calebschmurr/AUNA_Test_Box/Computer_App/Tests/CCC Test/img4.png

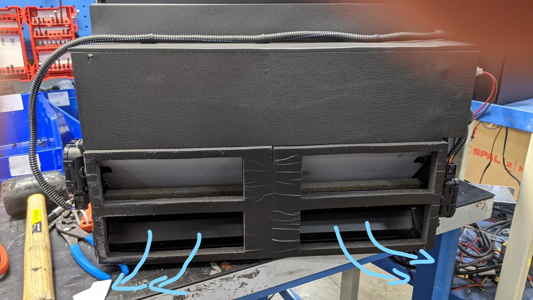
Computer_App/Tests/CCC Test/img4.png
