calebschmurr/AUNA_Test_Box/Computer_App/Tests/H49 Test/img1.png

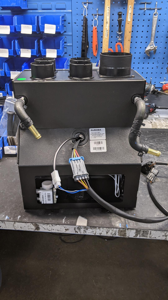
Computer_App/Tests/H49 Test/img1.png
