calebschmurr/AUNA_Test_Box/README.md

# AUNA_Test_Box
AUNA Test Box Program.

For use by Aurora North America

Caleb Schmurr
1/18/2021
