calebschmurr/AUNA_Test_Box/Computer_App/demo_img.png

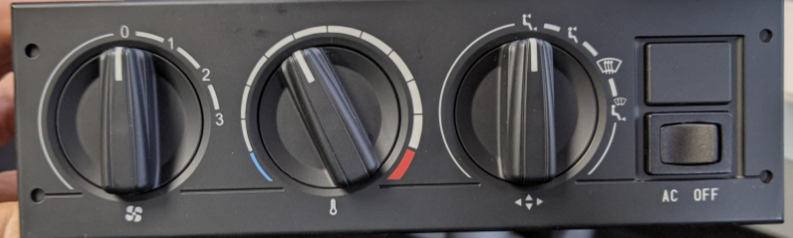
Computer_App/demo_img.png
