calebschmurr/AUNA_Test_Box/Box_Layout/Parts_List.xlsx

No | Part | Description | Quantity/Box | Link | Cost | Quantity | Total Number | Total Cost | Total:
X1 | 1-967624-1 | 18 Pole Connector Housing | 1 | https://www.digikey.com/en/products/detail/te-connectivity-amp-connectors/1-967624-1/2054114 | $1.85 | 1 | 1 | $1.85 | 162.3
X1 | 927768-3 | X1 Connector Pins | 100 | https://www.mouser.com/ProductDetail/TE-Connectivity-AMP/927768-3-CUT-STRIP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 | $0.15 |  | 100 | $15.00
X1 | 967634-1 | X1 Connector Pins | 1 | https://www.mouser.com/ProductDetail/TE-Connectivity/967634-1?qs=rjnFDYRVT0rJvfzEmt5HXw%3D%3D | $0.60 |  | 1 | $0.60
 |  |  |  |  |  |  | 0 | $0.00
X1 Mate | 1-967629-1 |  | 3 | https://www.mouser.com/ProductDetail/TE-Connectivity-AMP/6-968974-1?qs=VCyXNGXRS8bfC8%252Bz99ZYjg%3D%3D | $1.87 |  | 3 | $5.61
X1 Mate | 968946-1 |  | 60 | https://www.mouser.com/ProductDetail/TE-Connectivity/1-968946-1-Loose-Piece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 | $0.41 |  | 60 | $24.60
X1 Mate | 967634-1 |  | 3 | https://www.mouser.com/ProductDetail/TE-Connectivity/967634-1?qs=rjnFDYRVT0rJvfzEmt5HXw%3D%3D | $0.60 |  | 3 | $1.80
X2 | 776437-2 | 12 Pol Housing Receptacle | 1 | https://www.mouser.com/ProductDetail/TE-Connectivity/776437-2?tetid=saoE9FRHD7 | $5.36 |  | 1 | $5.36
X2 | 776297-2 | Receptacles | 12 | https://www.mouser.com/ProductDetail/TE-Connectivity/776297-2?qs=UO%2Fx91QLkSDJ2jPfP3drEg%3D%3D | $1.02 |  | 12 | $12.24
X2 Mate | 776438-2 | 12 Pol Housing Tab |  | https://www.mouser.com/ProductDetail/TE-Connectivity/776438-2?qs=tLAa1RwIH6cWRKxiiHtJdw%3D%3D | $3.79 |  | 0 | $0.00
X2 Mate | 776300-2 | Pins | 12 | https://www.mouser.com/ProductDetail/TE-Connectivity/776300-2/?qs=tLAa1RwIH6foPPkQZj%2Fzwg%3D%3D | $0.47 |  | 12 | $5.64
 | 12V Power Supply |  | 1 | https://www.amazon.com/eTopxizu-Universal-Regulated-Switching-Computer/dp/B00D7CWSCG | $20.95 |  | 1 | $20.95
 |  |  |  |  |  |  | 0 | $0.00
 | 24V Power Supply |  | 1 | https://www.amazon.com/ALITOVE-Universal-Regulated-Switching-Transformer/dp/B06XK2ZNKC | $24.99 |  | 1 | $24.99
 |  |  |  |  |  |  | 0 | $0.00
 |  |  |  |  |  |  | 0 | $0.00
 | Power Cord | 120V Power Cord | 1 | https://www.amazon.com/Bergen-Industries-Inc-PS915143-Appliance/dp/B07BQ8PY21 | $7.71 |  | 1 | $7.71
 |  |  |  |  |  |  | 0 | $0.00
 | 10k Resistors | Pack of 100 | 1 | https://www.amazon.com/EDGELEC-Resistor-Tolerance-Multiple-Resistance/dp/B07QJB31M7 | $5.99 |  | 1 | $5.99
 | 1k Resistors | Pack of 100 | 1 | https://www.amazon.com/EDGELEC-Resistor-Tolerance-Resistance-Optional/dp/B07HDDWFDD | $4.99 |  | 1 | $4.99
 | Soldered Breadboards | Pack of 5 | 1 | https://www.amazon.com/Dreyer-Electronics-Breadboard-Soldering-Prototypes/dp/B08RJCS7WZ | $9.99 |  | 1 | $9.99
 |  |  |  |  |  |  | 0 | $0.00
 | Test Box |  |  |  |  |  | 0 | $0.00
 |  |  |  |  |  |  | 0 | $0.00
 | Male to Male Cables | 20 Male to Male Cables. | 1 | https://www.amazon.com/Breadboard-Wires-Jumper-Multicolored-Raspberry/dp/B01GK2Q4ZQ?s=electronics | $5.99 |  | 1 | $5.99
 |  |  |  |  |  |  | 0 | $0.00
 | Relay Module | 8 Channel Relay Module | 1 | https://www.amazon.com/JBtek-Channel-Module-Arduino-Raspberry/dp/B00KTELP3I | $8.99 |  | 1 | $8.99
 |  |  |  |  |  |  | 0 | $0.00
 | Voltage Adapter |  |  |  |  |  | 0 | $0.00
 |  |  |  |  |  |  | 0 | $0.00
 |  |  |  |  |  |  | 0 | $0.00
 |  |  |  |  |  |  | 0 | $0.00
