calebschmurr/AUNA_Test_Box/Computer_App/Tests/H49 Test/H49 Test.txt

{"name": "H49 Test", "description": "Testing the H49 Unit.  Makes sense.", "pins": [{"pin": 54, "description": "AC Continuity"}, {"pin": 75, "description": "Blower Speed"}, {"pin": 22, "description": "AC Signal"}, {"pin": 23, "description": "Blower Power"}], "tests": [{"number": 0, "description": "Start Stage", "image": "img0.png", "error": "H49 Unit Error on Start", "pin_check": [{"pin": 54, "check_code": 1, "expected_value": 100}, {"pin": 75, "check_code": 0, "expected_value": 0}, {"pin": 22, "check_code": 0, "expected_value": 0}, {"pin": 23, "check_code": 0, "expected_value": 0}]}, {"number": 1, "description": "AC Continuity Check", "image": "img1.png", "error": "H49 Unit Error on Start", "pin_check": [{"pin": 54, "check_code": 2, "expected_value": 100}, {"pin": 75, "check_code": 0, "expected_value": 0}, {"pin": 22, "check_code": 0, "expected_value": 1}, {"pin": 23, "check_code": 0, "expected_value": 0}]}, {"number": 2, "description": "Blower on 50% and AC Sw Off.", "image": "img2.png", "error": "Blower not to 50%", "pin_check": [{"pin": 54, "check_code": 1, "expected_value": 100}, {"pin": 75, "check_code": 0, "expected_value": 63}, {"pin": 22, "check_code": 0, "expected_value": 0}, {"pin": 23, "check_code": 0, "expected_value": 1}]}, {"number": 3, "description": "Blower to 100%", "image": "img3.png", "error": "Blower not to 100%", "pin_check": [{"pin": 54, "check_code": 1, "expected_value": 100}, {"pin": 75, "check_code": 0, "expected_value": 127}, {"pin": 22, "check_code": 0, "expected_value": 0}, {"pin": 23, "check_code": 0, "expected_value": 1}]}, {"number": 4, "description": "Blower off", "image": "img4.png", "error": "Blower not turned off", "pin_check": [{"pin": 54, "check_code": 1, "expected_value": 100}, {"pin": 75, "check_code": 0, "expected_value": 0}, {"pin": 22, "check_code": 0, "expected_value": 0}, {"pin": 23, "check_code": 0, "expected_value": 1}]}, {"number": 5, "description": "Unit Power Off", "image": "img5.png", "error": "Unit not powered off.", "pin_check": [{"pin": 54, "check_code": 1, "expected_value": 100}, {"pin": 75, "check_code": 0, "expected_value": 0}, {"pin": 22, "check_code": 0, "expected_value": 0}, {"pin": 23, "check_code": 0, "expected_value": 0}]}]}
