calebschmurr/AUNA_Test_Box/Computer_App/Tests/CCC Test/img6.png

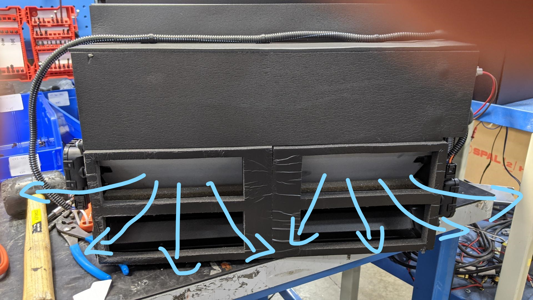
Computer_App/Tests/CCC Test/img6.png
