calebschmurr/AUNA_Test_Box/Computer_App/Tests/CCC Test/img9.png

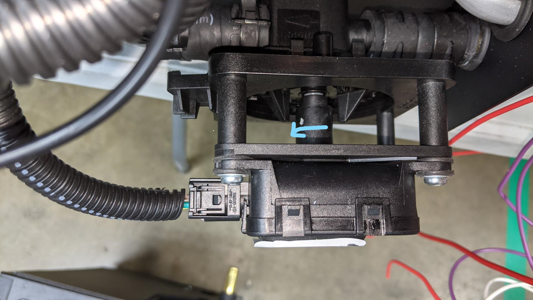
Computer_App/Tests/CCC Test/img9.png
