calebschmurr/AUNA_Test_Box/Box_Layout/Test_Box_Layout.pdf

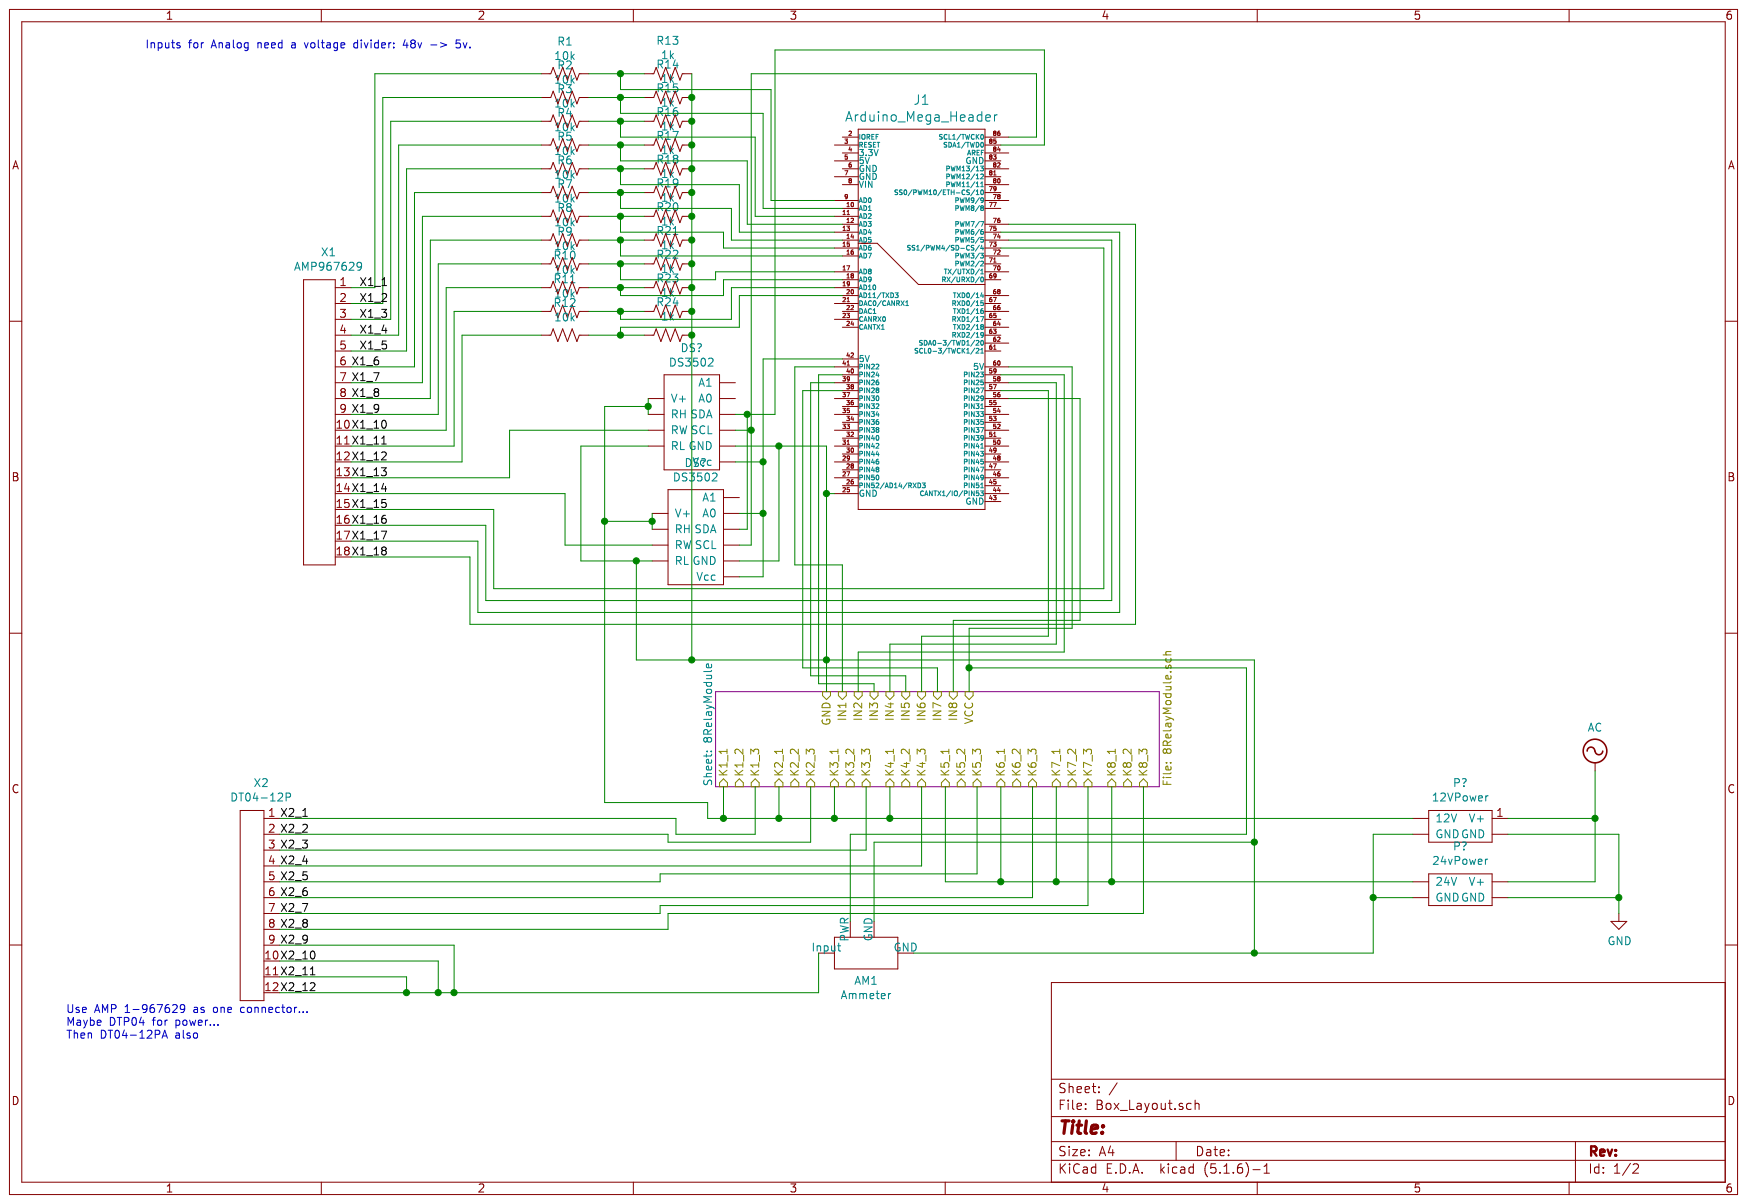
[picture p6: page 1]

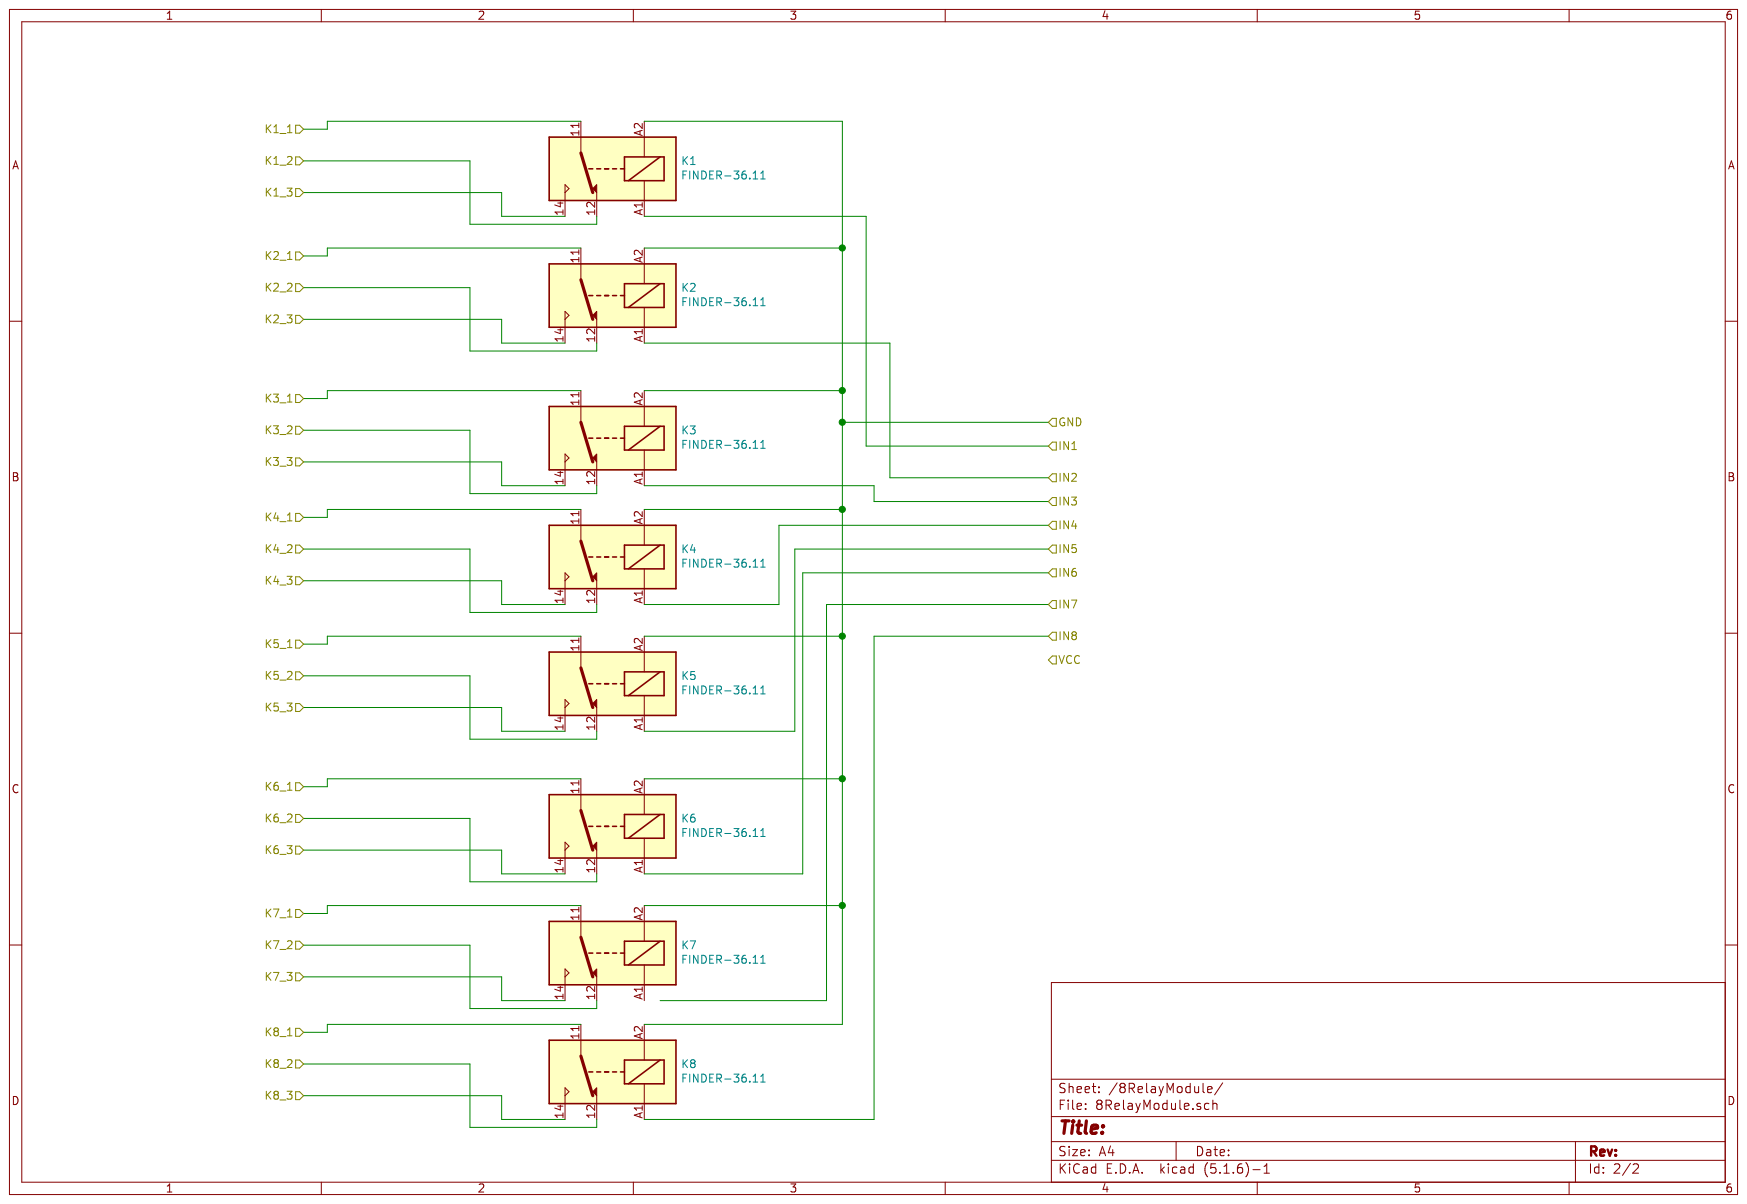
[picture p7: page 2]
