calebschmurr/AUNA_Test_Box/Box_Layout/Test_Box_Layout_Update6-2-21.pdf

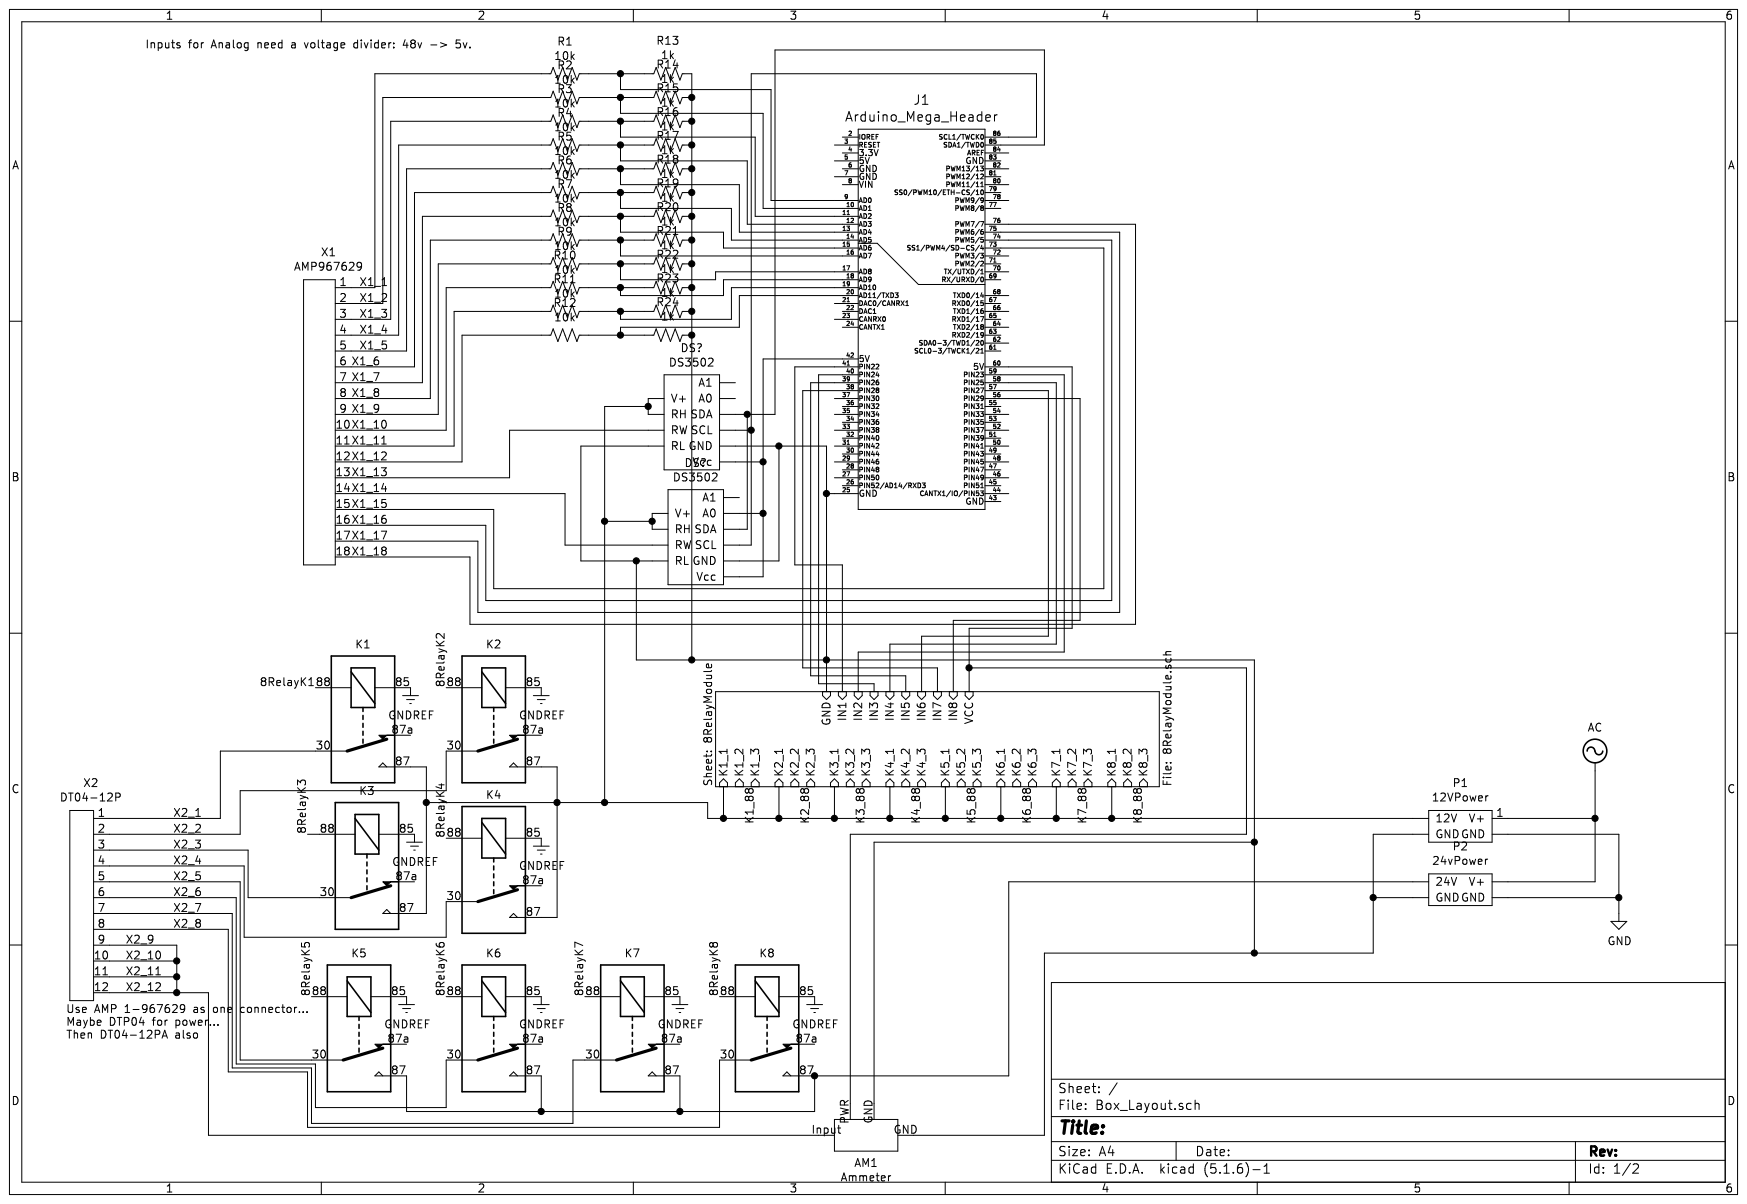
[picture p8: page 1]

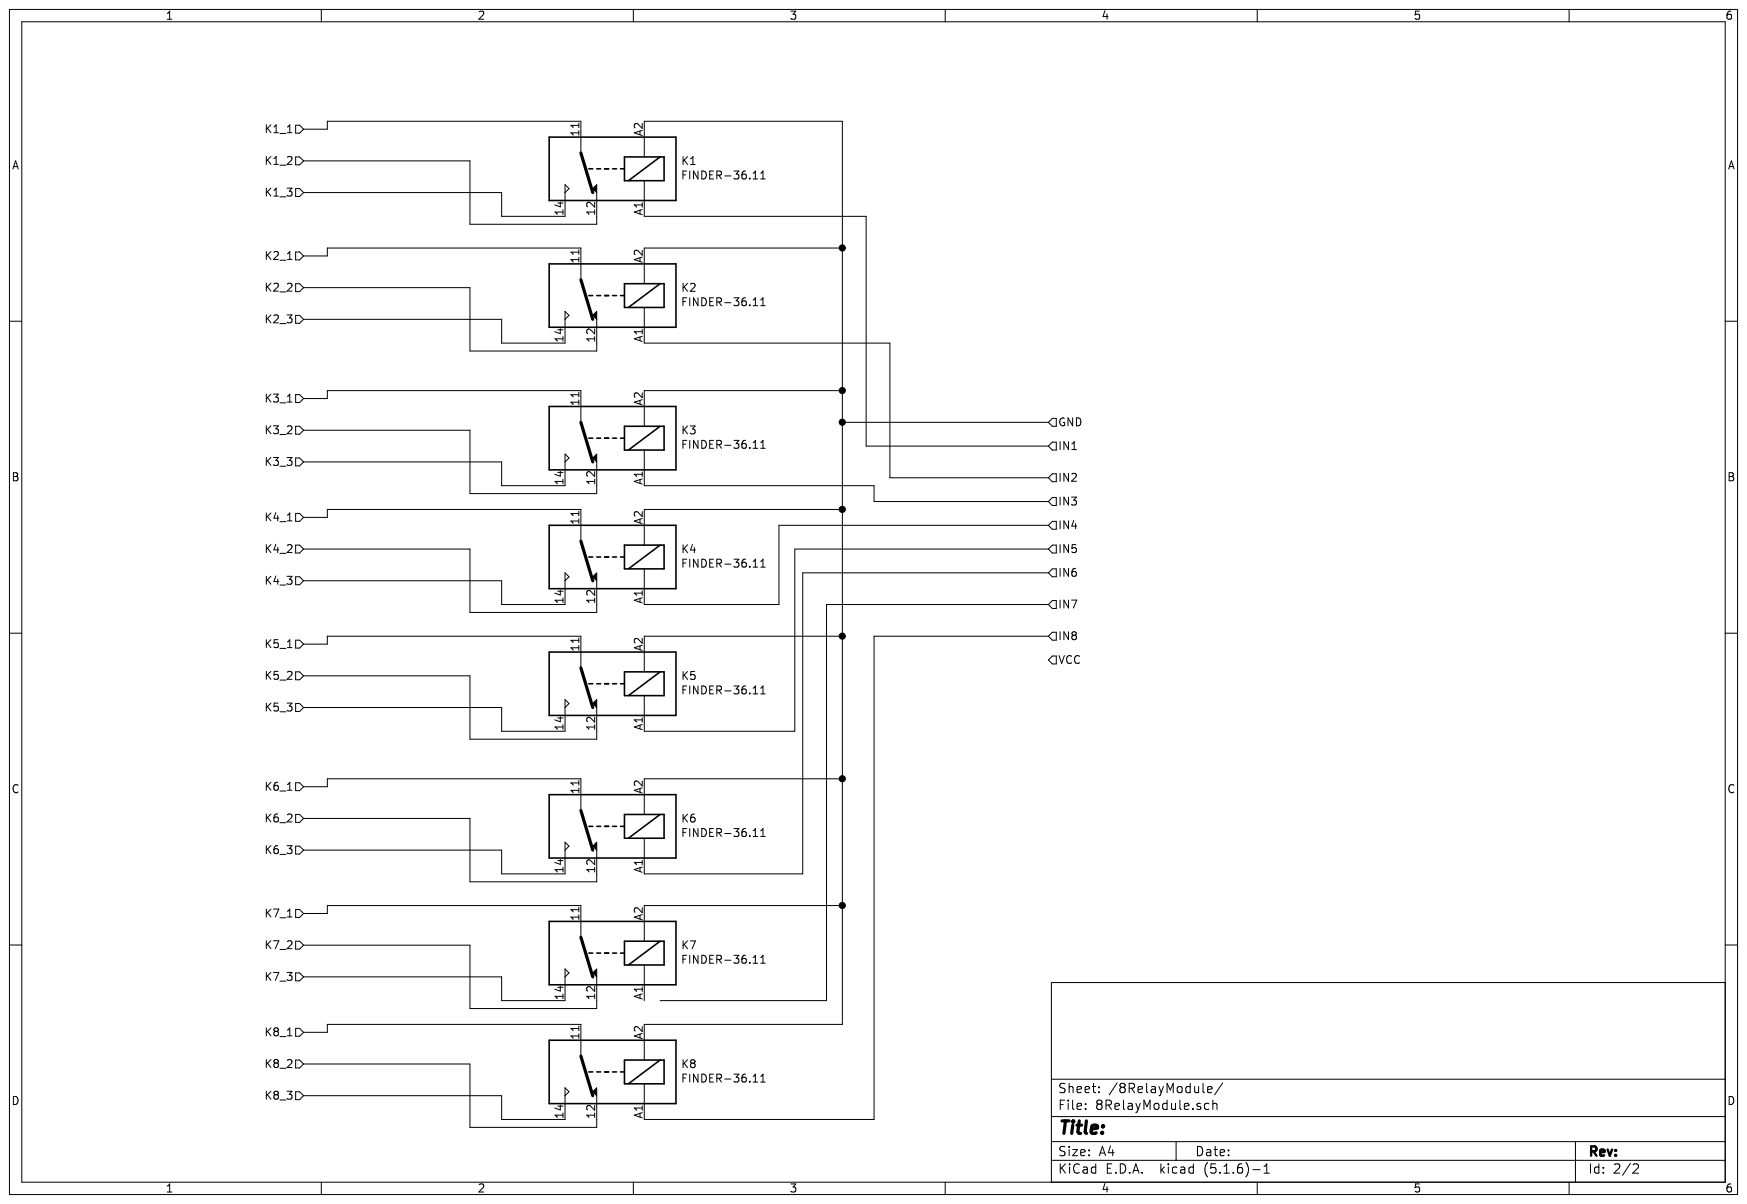
[picture p9: page 2]
