calebschmurr/AUNA_Test_Box/Box_Layout/Box_Layout.kicad_pcb

## KiCad design EECAD/ArtificialFinger.sch

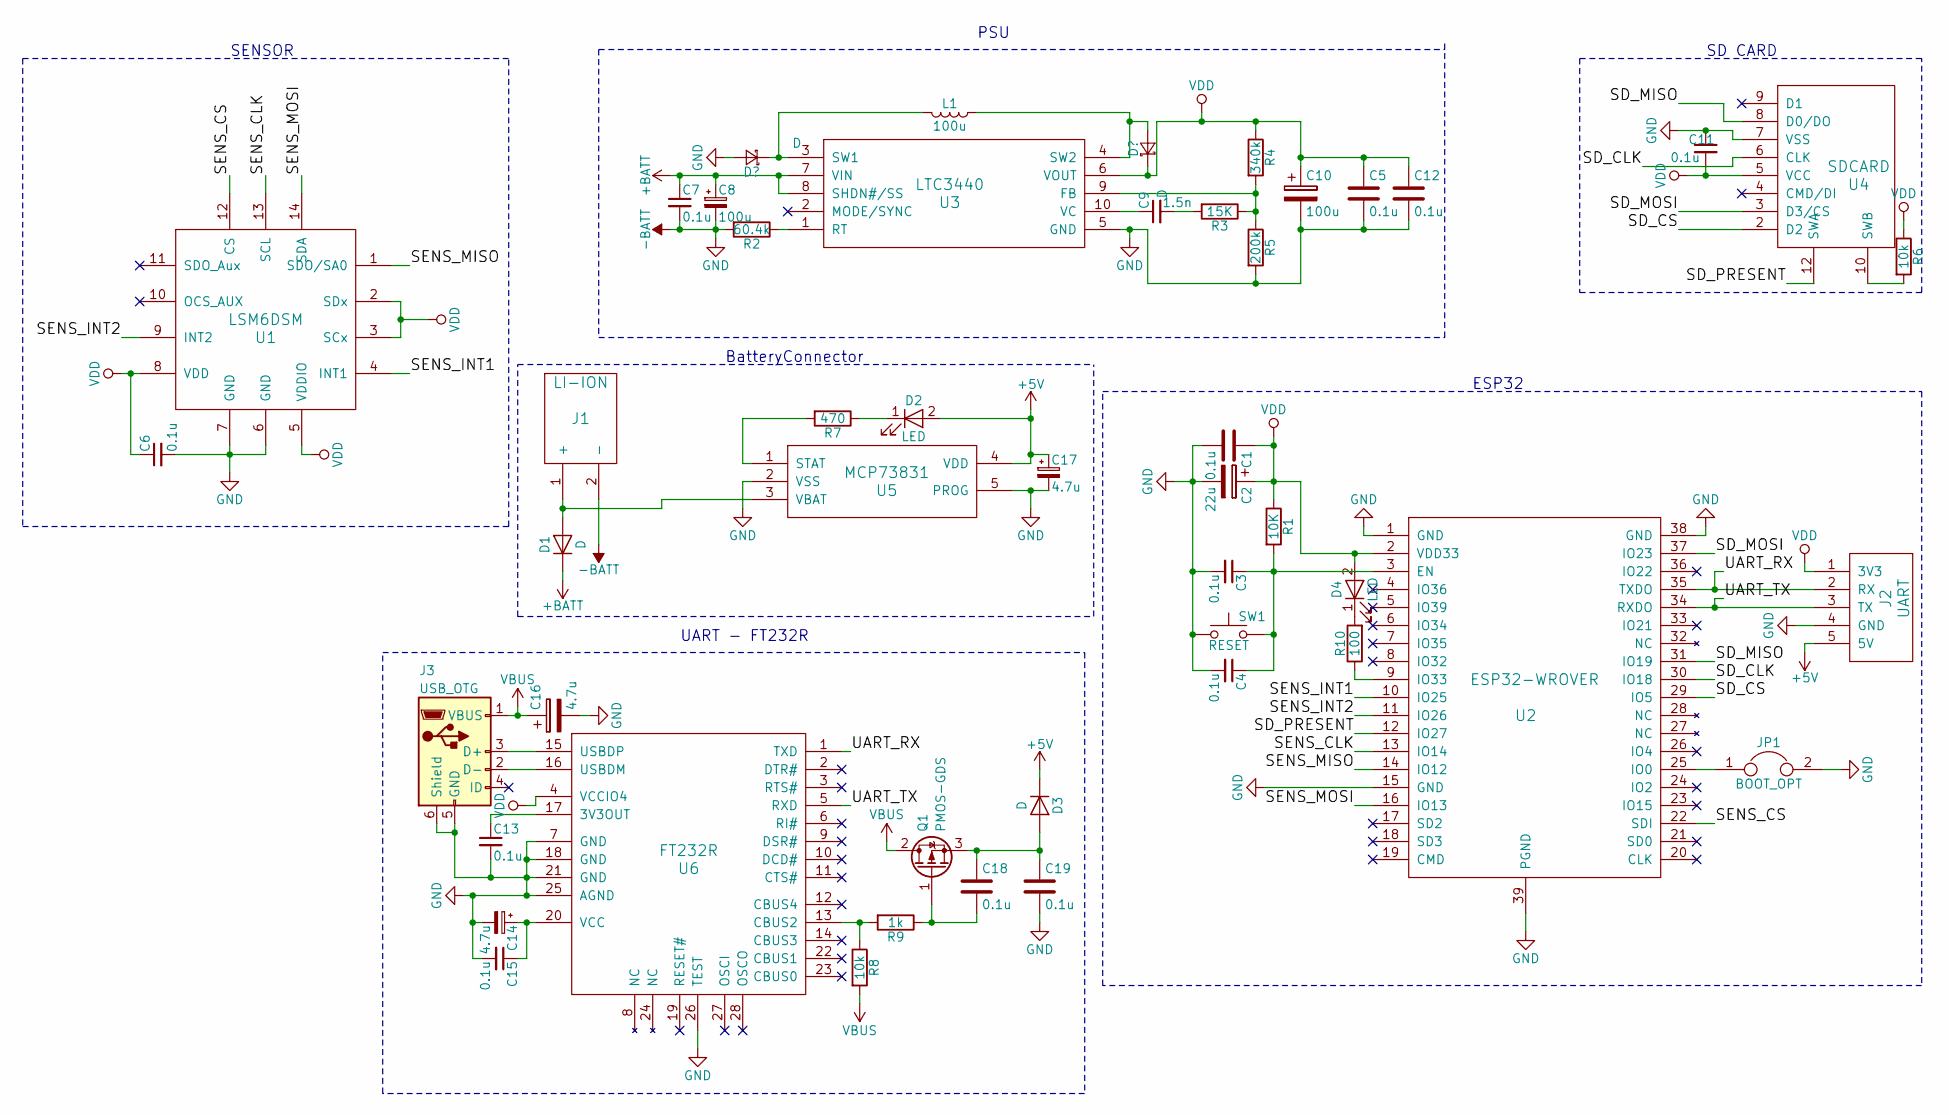
[picture p10: schematic ArtificialFinger.sch]

Parts:
C1, C3, C4, C6, C7, C11, C13, C15, C18, C19: 0.1u; C_0805_HandSoldering
C2: 22u; C_1206_HandSoldering
C5, C12: 0.1u
C8, C10: 100u; CP_Radial_D6.3mm_P2.50mm
C9: 1.5n; C_0805_HandSoldering
C14, C16, C17: 4.7u; C_0805_HandSoldering
D1, D3: D
D2, D4: LED
J1: LI-ION
J2: UART
J3: USB_OTG
JP1: BOOT_OPT
L1: 100u
Q1: PMOS-GDS
R1: 10K; C_0805_HandSoldering
R2: 60.4k; C_0805_HandSoldering
R3: 15K; C_0805_HandSoldering
R4: 340k; C_0805_HandSoldering
R5: 200k; C_0805_HandSoldering
R6, R8: 10k; C_0805_HandSoldering
R7: 470; C_0805_HandSoldering
R9: 1k; C_0805_HandSoldering
R10: 100
SW1: RESET
U1: LSM6DSM
U2: ESP32-WROVER
U3: LTC3440
U4: SDCARD
U5: MCP73831
U6: FT232R

Connections:
+5V: C17.1, D2.2 (A), D3.1 (K), J2.5 (5V), U5.4 (VDD)
+BATT: C7.1, C8.1, D1.1 (K), U3.7 (VIN), U3.8 (SHDN#/SS)
-BATT: C1.2, C2.2, C3.2, C4.2, C5.2, C6.2, C7.2, C8.2, C10.2, C11.1, C12.2, C13.2, C14.2, C15.2, C16.2, C17.2, C19.2, J1.2 (-), J2.4 (GND), J3.5 (GND), J3.6 (Shield), JP1.2, R2.2, R5.2, SW1.1, U1.6 (GND), U1.7 (GND), U2.1 (GND), U2.15 (GND), U2.38 (GND), U2.39 (PGND), U3.5 (GND), U4.7 (VSS), U5.2 (VSS), U5.5 (PROG), U6.7 (GND), U6.18 (GND), U6.21 (GND), U6.25 (AGND), U6.26 (TEST)
unnamed: C3.1, C4.1, R1.2, SW1.2, U2.3 (EN)
unnamed: C9.1, U3.10 (VC)
unnamed: C9.2, R3.2
unnamed: C13.1, U6.17 (3V3OUT)
unnamed: C14.1, C15.1, U6.20 (VCC)
unnamed: C18.1, C19.1, D3.2 (A), Q1.3 (S)
unnamed: C18.2, Q1.1 (G), R9.1
unnamed: D1.2 (A), J1.1 (+), U5.3 (VBAT)
unnamed: D2.1 (K), R7.1
unnamed: D4.1 (K), R10.2
unnamed: J3.2 (D-), U6.16 (USBDM)
unnamed: J3.3 (D+), U6.15 (USBDP)
unnamed: JP1.1, U2.25 (IO0)
unnamed: L1.1, U3.4 (SW2)
unnamed: L1.2, U3.3 (SW1)
unnamed: R2.1, U3.1 (RT)
unnamed: R3.1, R4.2, R5.1, U3.9 (FB)
unnamed: R6.2, U4.10 (SWB)
unnamed: R7.2, U5.1 (STAT)
unnamed: R8.1, R9.2, U6.13 (CBUS2)
unnamed: R10.1, U2.9 (IO33)
SD_CLK: U2.30 (IO18), U4.6 (CLK)
SD_CS: U2.29 (IO5), U4.2 (D2)
SD_MISO: U2.31 (IO19), U4.8 (D0/DO)
SD_MOSI: U2.37 (IO23), U4.3 (D3/CS)
SD_PRESENT: U2.12 (IO27), U4.12 (SWA)
SENS_CLK: U1.13 (SCL), U2.13 (IO14)
SENS_CS: U1.12 (CS), U2.22 (SDI)
SENS_INT1: U1.4 (INT1), U2.10 (IO25)
SENS_INT2: U1.9 (INT2), U2.11 (IO26)
SENS_MISO: U1.1 (SDO/SA0), U2.14 (IO12)
SENS_MOSI: U1.14 (SDA), U2.16 (IO13)
UART_RX: J2.2 (RX), U2.35 (TXDO), U6.1 (TXD)
UART_TX: J2.3 (TX), U2.34 (RXDO), U6.5 (RXD)
VBUS: C16.1, J3.1 (VBUS), Q1.2 (D), R8.2
VDD: C1.1, C2.1, C5.1, C6.1, C10.1, C11.2, C12.1, D4.2 (A), J2.1 (3V3), R1.1, R4.1, R6.1, U1.2 (SDx), U1.3 (SCx), U1.5 (VDDIO), U1.8 (VDD), U2.2 (VDD33), U3.6 (VOUT), U4.5 (VCC), U6.4 (VCCIO4)

Notes on the sheet:
SD CARD
ESP32
BatteryConnector
PSU
SENSOR
UART - FT232R
