calebschmurr/AUNA_Test_Box/Arduino_Code/Manitou_Demo/Manitou_Demo.ino

#include "PinsList.h"
#include <VariableTimedAction.h>
#include <math.h>

#include <Adafruit_DS3502.h>

//Declare input array of size 200;
//For Serial input:  


//https://www.arduino.cc/en/Tutorial/BuiltInExamples/SerialEvent

//char inputArrayVal[200];
//char * inputArray = inputArrayVal;
String inputArray;
bool stringComplete = false;

int i = 0;

int Debug = 1; //Debug Level.
unsigned loc;
int output_mode;
int outputTime;


//1:23.I;24.I;25.I;26.I;27.I;28.O;!
PinsList pin_list;


//Declare the ds3502 devices:
Adafruit_DS3502 varOut1 = Adafruit_DS3502();
Adafruit_DS3502 varOut2 = Adafruit_DS3502();


/*
 * PinValSender - this is what is used to send back
 * a signal that contains the registered pins info.
 * 
 */
class PinValSender : public VariableTimedAction {

  private:

  /*
   * Format for sending back data:
   * #1;01:2.2;02:3.2;05:1.2;07:1.8;
   * 
   * Format:
   * [#1];[pin_number]:[value];[pin_number]:[value];[pin_number]:[value];
   * Initialize command with #1
   * pin_number - the pin_number to return.
   * value - the value of the pin to return.
   * 
   */
  
  unsigned long run(){
    //Run the code in here:

    //TODO: Translate the Analog Input pins to use 8 instead of A as variable name
    //for passing back and forth.

    //Also TODO: For parsing input values of pins, change the size of the input to be 3 chars.
    //Initialize the send-back code:
    Serial.print("#1;");
    for (i = 0; i < pin_list.getNumberActivePins(); i++) {
      //Check to see what type of pin it is: output or input.
      if (pin_list.getIfInputPin(i)) {
        //If pin is input, then print the value to Serial.
       if (pin_list.getPinNumber(i)<10) {
          Serial.print("0");
          Serial.print(pin_list.getPinNumber(i));
        }else{
          Serial.print(pin_list.getPinNumber(i));
        }
        Serial.print(":");
        if (pin_list.getPinMode(i) == PinAnalogInput) {
          Serial.print(analogRead(pin_list.getPinNumber(i)));
          Serial.print(",");
        } else if (pin_list.getPinMode(i) == PinDigitalInput){
          Serial.print(digitalRead(pin_list.getPinNumber(i)));
          Serial.print(",");
        }
      }
    }
    Serial.print("!\n");
    return 0;
  }
public:
  
  
};

PinValSender PinValueSender;
void(* resetFunc) (void) = 0; //Declare reset function.


void setup() {
  inputArray.reserve(200);
  //Declare pins 22-29 as outputs.
  for (int i = 22; i < 30; i++){
    pinMode(i, OUTPUT);
  }
  Serial.begin(115200);

  while(!Serial){
    
  }
  Serial.println("Open.\n");


  //https://learn.adafruit.com/ds3502-i2c-potentiometer/arduino
  //Initialize the two DS3502 pins:
  if (!varOut1.begin(0x28)){
    Serial.println("Couldn't find DS3502 chip for varOut1.");
    //while (1);
  }
  if (!varOut2.begin(0x29)){//Start on address line 0x29.
   Serial.println("Couldn't find DS3502 chip for varOut2.");
 //   while (1);
  } 

  //Set the output to 0:
  varOut1.setWiper(0); //Max Voltage
  varOut2.setWiper(0); //Max Voltage
  //Finished setup.
}


void loop() {
  // put your main code here, to run repeatedly:

    if (stringComplete){
      processInput();
    }

    VariableTimedAction::updateActions();

      //Automatically Called: serialEvent();
}


void serialEvent(){ //This is automatically called at the end of the loop, 
  while (Serial.available()){
    char inChar = (char)Serial.read();
    //Add it to the input string:
    inputArray += inChar;
    //If terminated, set a flag so the mainloop can read in the string:
    if (inChar == '\n') {
      stringComplete = true;
    }
  }

}


/*
 * sendPinItems()
 * Method to return the values found in pinlist: 
 */

/*
 * processInput() method
 * Used to receive inputs from Serial communication
 * 
 */
int processInput(){

    ////***********************////////
    //// Receive Pin Reset Command [0] ////
    if (inputArray[0] == '0'){
      //Reset - clear active pins, clear pin list, etc.
      if (Debug){
          Serial.println("Reset called.");
      }
      
      //For each pin in the pin list,
      //reset the pin by setting it to input, the default state.
      for (int i = 0; i < pin_list.active_pin_list_size; i++){
        digitalWrite(pin_list.getPinNumber(i), LOW);
        delay(5);
        pinMode(pin_list.getPinNumber(i), INPUT);
      }
      Serial.println("Wrote all pins to low.");
      //Clear the pins list.
      pin_list.clear_pin_list();
       //Set all relay pins to output.
       for (int i = 22; i < 30; i++){
         pinMode(i, OUTPUT);
       }
      delay(10);


      
    ///**************************/////
    //Receive Pin Setup Command [1] /////////
    } else if (inputArray[0] == '1'){
      
      //Debug Message.
      if (Debug) {
        Serial.println("Setup Pins command called.");
        Serial.println(inputArray);
      }


      loc = 2; //declare location
      
      //Below are all the input variables for parsing system input.
      char pin_num[3]; //holder for pin value
      unsigned u_pin_num = 0;
      pin_num[3] = '\0';
      i = 0;
      
      //While there are more pins to input:
      while (inputArray[loc] != '!'){
        //Start off getting the pin number:
        pin_num[0] = inputArray[loc];
        pin_num[1] = inputArray[loc+1];

        loc+=3;  //Increment by 3, moving to the next pin number.
        u_pin_num = atoi(pin_num);
        
        if (Debug) {
          Serial.print("Pin_num: ");
          Serial.println(pin_num);
        }

        //PinMode assignment based on the pin number.
        //If pin is less than 8, the pin is PWM/Digital Output.
        //So, set it up to be PWM.
        if (u_pin_num < 8) {
          //Set pin to Output mode
          pinMode(u_pin_num, OUTPUT);
          pin_list.add_pin(u_pin_num, PinOutput);

          if (Debug){
            Serial.print("Pin ");
            Serial.print(u_pin_num);
            Serial.print(" is set to be PWM/Digital output.");
          }

        //If the pin number is less than 30, the pin is a GPIO pin.
        //Setup as GPIO output.  These are for 12V and 24V output relay control.
        } else if (u_pin_num < 30){
              pinMode(u_pin_num, OUTPUT);
              pin_list.add_pin(u_pin_num, PinOutput);
            if (Debug) {
              Serial.print("Pin ");
              Serial.print(u_pin_num);
              Serial.print(" is set to Output.\n");
            }

        //If the pin number is less than 66, then the pin is Analog Input.
        //Setup the pin as an analog input.
        } else if (u_pin_num < 66){
            pinMode(u_pin_num, INPUT_PULLUP);
            pin_list.add_pin(u_pin_num, PinAnalogInput);

            if(Debug){
              Serial.print("Pin ");
              Serial.print(u_pin_num);
              Serial.print(" is set to Analog Input.");
            }
        

        //If the pin is less than 77, then the pin is for the DS11 chip.
        //Don't do anything here...

        } else if (u_pin_num < 77){
            //Nothing to do here.  The pin is defaulted to be on.

        }else {
          //ERROR CASE
          Serial.println("Error - improper values given.");
          break;
        }
        //Reset Iterators.
        memset(pin_num, 0, sizeof pin_num);

      }

    /*
     * List pins
     *  On finish parsing the pins, it lists all the pins.
     * 
     */

  Serial.print("Listing Pins:\n");
  for (int i = 0; i<pin_list.active_pin_list_size; i++){
    Serial.print("Pin ");
    Serial.print(pin_list.getPinNumber(i));
    Serial.print(" is status ");
    Serial.println(pin_list.getPinMode(i));
  }
  Serial.println("Pins Listed.");

//Finish listing pins.

/**************************************/

/****************************************/

  //Receive the command to adjust the Arduino Serial Output.
  } else if (inputArray[0] == '2'){

    if (Debug) {
        Serial.println("Setup Output Called");
        Serial.println(inputArray);
    }

    //Assign location.
    loc=2;
    unsigned sizeofTime = 0; //Declare the size of the time char.
    char inputChar[2]; //Declare the input char.
    inputChar[1] = '\0'; //Set termination.

    //Receive the code for starting or stopping time output.
    inputChar[0] = inputArray[loc];

    output_mode = atoi(inputChar); //Set the output mode variable.
     
    loc = 5;

    //Parse through the char that contains the time between transmissions
     while (inputArray[loc] != '!') {
          loc++;
          sizeofTime++;
          if (loc > 1200) {
            Serial.println("Error - command too long.");
            break;
          }
     }

      //Once we have the length of the time var, parse the actual time var.

     for (i = 1; i < sizeofTime+1; i++){

      if (Debug) {
        Serial.println(inputArray[loc-i]);
      }

      inputChar[0] = inputArray[loc-i];

      //Add to the outputTime variable, multiplying by a power of 10 for each addition.
      outputTime += (atoi(inputChar) * pow(10,i-1))+1; //For some reason, have to include +1 on the operation, otherwise time var does not update properly.
      
      if (Debug) {
          Serial.print("pow: ");
          Serial.println(pow(10,i-1));
          Serial.println(outputTime);
          Serial.println("restart_loop");
        }
     
     }
     if (output_mode==1) {
      PinValueSender.start(outputTime);
     } else {
      PinValueSender.stop();
     }
     
     if (Debug) {
        Serial.print("Output Mode: ");
        Serial.print(output_mode);
        Serial.print(", and output time: ");
        Serial.println(outputTime);
     }


/*************************************************************************/


    //COMMAND 3 //Configure the output of pins////////////////////////////////////
    //3:02.0,13.4!
    //Send command as follows:
/* [3]:[00].[001],[00],[255]!
 * [3]:[pin].[value from 0-255],[pin].[value from 0-255]!
 * When configuring the output, choose a value from 0-255 for PWM,
 * or 0 or 255 for digital output pins.
 * 
 */

   } else if (inputArray[0] == '3'){
      //Control output variables - determine which ones should be output.
      Serial.println("Case 3");
      Serial.println("Configure output value of a pin.");

      loc = 2; //declare location
      unsigned pinTypeLen = 0;
      char pin_num[3] = {'0', '0', '\0'}; //holder for pin value
      char pin_value[4] = {'0', '0', '0', '\0'}; //holder for the pin type.
      int new_pin_num = 0;
      int new_pin_val = 0;
      i = 0;
      
      //While the input is not terminating parse input:
      while (inputArray[loc] != '!'){
        //Get the pin number, and value to change it to.
        pin_num[0] = inputArray[loc];
        pin_num[1] = inputArray[loc+1];  
        pin_value[0] = inputArray[loc+3];
        pin_value[1] = inputArray[loc+4];
        pin_value[2] = inputArray[loc+5];
        loc+=7;
        new_pin_num = atoi(pin_num);
        new_pin_val = atoi(pin_value);
        //Determine if the pin selected is a valid output pin.
        
        //cycle through active pins.           
          if (pin_list.getPinIndex(new_pin_num) != -1){
             //Pin is a valid output pin.
             
             //If the new pin is a PWM pin::
             if(new_pin_num > 1 && new_pin_num < 14){

                  //New pin is PWM
                  analogWrite(new_pin_num, new_pin_val);
                
             } else if (new_pin_num > 21 && new_pin_num < 70){
              //New pin is standard GPIO

              Serial.println(new_pin_val);
                if(new_pin_val > 0){
                  digitalWrite(new_pin_num, HIGH);
                  Serial.println("Pin ");
                  Serial.println(new_pin_num);
                  Serial.println("Set to HIGH");
                } else {
                  digitalWrite(new_pin_num, LOW);
                  Serial.println("Pin ");
                  Serial.println(new_pin_num);
                  Serial.println("Set to LOW");
                }
                
             } else {
              Serial.print("Pin ");
              Serial.print(new_pin_num);
              Serial.println(" is not a valid GPIO/PWM pin.");
             }

          }else if (new_pin_num == 75 || new_pin_num == 76){

                //If the new pin is pin X1_13 or X1_14 (2 or 3) - use the DS3502.
                //Wiper value can be set between 0 and 127. 0 = Max Resistance. 127 = Min Resistance.
                //LM2596 gets value from 24V - so scale accordingly.
                if (new_pin_num == 75){
                  varOut1.setWiper(new_pin_val);
                  Serial.println("Set Wiper varOut1 to ");
                  Serial.println(new_pin_val);
                }else if (new_pin_num == 76){
                  varOut2.setWiper(new_pin_val);
                } else {
                  //Should not be able to get here.
                  break;
                }

          }else{
            Serial.print("Pin ");
            Serial.print(new_pin_num);
            Serial.println(" is not an initiated output pin.");
          }
        }
    } else if (inputArray[0] == '4'){
      //Perform full reset:
      Serial.println("Full Reset...");
      resetFunc();
    } else {
      Serial.println("Command not recognized.");
    }
 
    //Clear the values of input.
  inputArray = "";
  stringComplete = false;
}
