calebschmurr/AUNA_Test_Box/(commit log)

2021-01-18 Added ability to receive analog input from arduino pins
2021-01-22 Worked on pin control ui stopping thread
    Unable to stop the PinControlUI Update Thread - pin control ui will now open and close on command, but for some reason does not close as needed.
2021-01-25 Fixed PinControlUI Close
    Now the full program closes on exiting MainWindowUI
    [SerialComm.py]
2021-01-25 Adding in the loading test capability.
    Added in tab switching on test load and check to make sure test is selected on test load. Next steps: Load in test JSON, create a class that contains all the test information. Then proceed through test process.
2021-01-29 Fixed some issues with storage of pinlist.
    TODO: Fix the input parsing of Pins on the pin_check. For some reason, the pins are getting double uploaded.
    [JSON_Test.py, PinList.py, TestSequence.py]
2021-02-01 Fixed PinList Output Issue
    Fixed issue with Tests outputting the pins twice in json dumps.
    [TestSequence.py]
2021-02-01 Tests load in succesfully
    Tests now load in from txt file, and the images update in the run tests tab.
    TODO:
    -Add in the actual pin checks for each stage, and configure the error messages to send.
    -Add in the test creator
    [JSON_Test.py, TestSequence.py]
2021-02-01 Change directory to file location directory
    Automatically changes command line directory to the current directory of the file, need to do this in order to update the file.
2021-02-08 Worked on adding the new test config
    Adding in pin selection for a new test in UI
2021-02-09 Adding pins to the test stages tab
    Worked on adding pins to test stages tab - still need to do this.
    May have to do before creating window/doing initial layout.
2021-02-10 More progress on creating a test procedure
    Adding in the ability to save stages in a new test.
    Next TODO:
    Img Handling - on selecting an image and moving on to the next step, write the image to the test folder.
2021-02-10 Added image saving on creating new tests
    Continue workign on the test saving process.
    At the save of a stage, get pin values.
    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
2021-02-15 Continued working on save function
    Finish the pin check saving for Pin Item
    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
2021-02-16 Potential fix of saving pins on new test stage
    Added in getitem() method to test pins, not sure if this will actually save properly though.
    [TestSequence.py]
2021-02-17 Still working on creating new tests - need to rethink the storage mechanism for stages.
    Use the CurrentStage method to save stages for test...
    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
2021-03-01 Fixed storage for pinslist
    Fixed the storage for pinslist system - using __getitem__. See onenote for next steps, left off at line 919.
    [TestSequence.py]
2021-03-02 Fixed Pin and Check_Code Storage between stages
    Fixed the pin and chceck_code storage so it saves, able to navigate between different stages in test creator mode.
    [TestSequence.py]
2021-03-03 Fixed Image Loading for Test Creation
    Added in the ability to load in, vies, and save pictures in test creation.
    TODO:: Saving tests, and modifying previously existing tests, and deleting old test
    [TestSequence.py]
2021-03-04 Added in navigation/control buttons
    TODO: Finish implementing modifyTestPushed - add in ability to modify existing tests.
    Then, start working on actually connecting Arduino to system. (Goal for next week.)
2021-03-05 Continued working on modifying tests feature
    When modifying a test, it now loads properly. Saving does not work.
    TODO: Fix the test saving of a test being modified.
    Currently still facing issues with this,
2021-03-08 Changes to modifications and save testing
    TODO: Rework the storage and loading mechanism
    [TestSequence.py]
2021-03-09 Fixing storage mechanism -
    TODO: Fix the X2 storage.
    [PinList.py, TestSequence.py]
2021-03-09 Fixed saving all of the test pins.
    Now, all test pins save.
    Add a Remove Stage button.
    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
2021-03-09 Began integrating Arduino with MainWindow
    todo: Continue implementing the actual Arduino testing w/ current program.
2021-03-10 Continuing the integration w/ test box.
    Updates to load test - on test load the pins are trying to be sent to the arduino.
2021-03-11 Changes to Initializing Serial Connection
    TODO: Make sure that the serial message to change pins on pinlist gets sent properly - right now it sends before the serial line has been opened and confirmation from Arduino is received.
2021-03-12 Worked on getting relays to work.
    Left off at line 899 of MainWindowUI.
    Finish checking if the pin is an output pin, then change the pin value.
2021-04-06 Added Arduino_Software.drawio
2021-04-06 Changes to Serial Comms
    Switching serial comms strategy
2021-04-06 Update to Serial Comms
    Fixed Serial Comms - now much faster, accurate. More of a handshaking protocol.
    [Manitou_Demo.ino, PinList.py]
2021-04-06 Slight readability improvements.
    Improved some readability of the Arduino code.
2021-04-07 Changes to Serial Connection, Code Simplification
    Added a few methods for simplification of code, and added in the autoconnect feature on loading a test.
    Serial automatically finds the correct serial port when necessary. TODO: Add in a check to make sure the serial line connects properly.
    [Manitou_Demo.ino, PinList.py, SerialComm.py, TestSequence.py]
2021-04-08 Added KiCad Schematic, Software Updates
    Added the KiCad schematic showing the circuit layout of the box. Compiled a list of parts needed for the box in an Excel sheet. Made changes to the software - changed some X1 pins to now be Input Only, and adjusted the test creation software to reflect this change.
    Still TODO:
    Fix the Pin Input system - Relay_Test has pins having faulty input. Adjust the program to show which pins have wrong input.
    [8RelayModule.sch, Box_Layout.kicad_pcb, Box_Layout.sch, Parts_List.xlsx]
2021-04-08 Fix to Check_Code.
    Fixed the Check_Code issue on output pins.
    [TestSequence.py]
2021-04-15 Parts List Update
    Change of Parts List
    [Parts_List.xlsx]
2021-04-21 Changes to schematic
    [Box_Layout.sch]
2021-04-22 Working on test navigation.
    Still issues with navigating the test creation.
    [Manitou_Demo.ino]
2021-05-24 Variable Voltage Out Working
    Fixed the DS3502 - variable voltage out now works.
    [Box_Layout.sch]
2021-06-02 Changes to layout, and a bit to code. Added a few tests.
    [Box_Layout.sch]
2021-06-03 Added pin storage method
2021-06-03 Added flowchart for usage
2021-06-04 Changes to Computer Software and Arduino Code to match standard laid out in flowchart
    TOOD: Continue working on Arduino code, left off at Input Command 1.
2021-06-08 Updated Arduino Code to fit new Serial standard.
    TODO: Update the Computer Software to meet the new Serial standard.
2021-06-10 Worked on implementing standards from flowchart.
    See Status document for next TODO, and an overview of what was done on 6/10.
2021-06-16 Bug fixes
    See status document for update.
    [PinList.py, TestSequence.py]
2021-06-18 Continued improvements and bug fixes, removed bad tests
    [Manitou_Demo.ino, PinList.py, SerialComm.py, TestSequence.py]
2021-06-21 Fixed some issues with values not loading into MasterPinList
    See Status document for updates.
    [PinList.py, SerialComm.py, TestSequence.py]
2021-06-21 Minor changes to software - fixed inversion of X2 connectors.
    Finished fixing changes
2021-06-22 Added the CCC and H49 Tests, minor bug fixes.
    [TestSequence.py]
2021-06-22 Fixed FinishTest Pins Clearing
    Adjustment to PinsList clearing
    [PinList.py]
